PhirePhly/USB-PiDU/README.md

# USB-PiDU
Multiple switchable USB DCP power ports on a Raspberry Pi-sized board
