PhirePhly/USB-PiDU/USBPiDU_pcb/BOM.txt

Right angle USB A ports:
  https://www.digikey.com/products/en?keywords=609-1041-ND
  https://www.digikey.com/products/en?keywords=ED2991-ND

Micro USB Connector
  https://www.digikey.com/products/en?keywords=609-4613-1-ND
  http://portal.fciconnect.com/Comergent//fci/drawing/10118192.pdf

USB Load Switch:
  https://www.digikey.com/products/en?keywords=AP22802AW5-7DICT-ND

5mm header:
  https://www.digikey.com/products/en?keywords=277-1667-ND
