PhirePhly/USB-PiDU/USBPiDU_pcb/USBPiDU.kicad_pcb

## KiCad design USBPiDU_pcb/USBPiDU.kicad_pcb (2017-06-24)

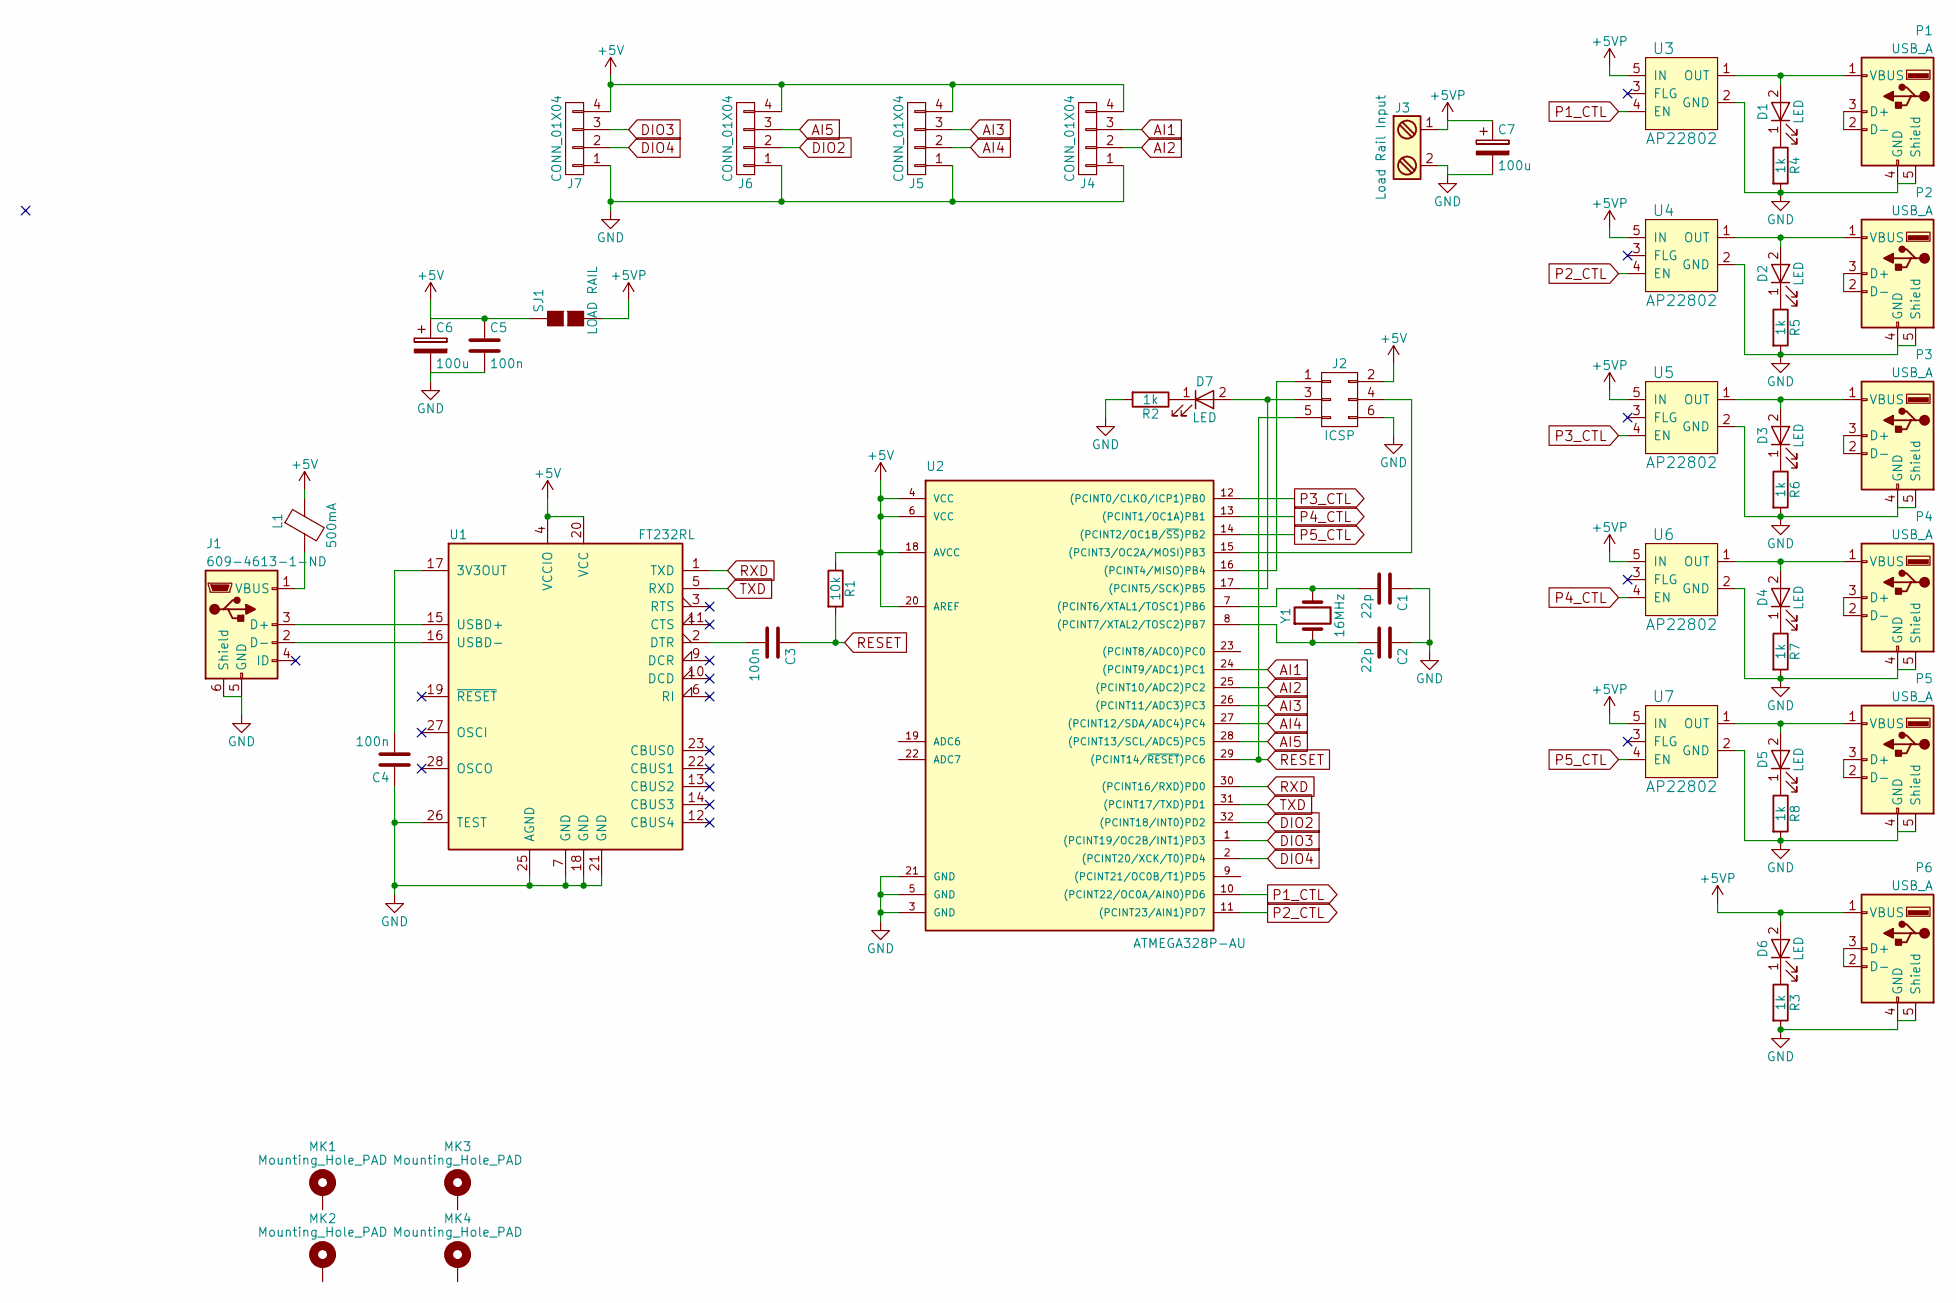
[picture p1: schematic USBPiDU.sch, Arduino USB PDU]

Parts:
C1, C2: 22p; C_0603_HandSoldering
C3, C4, C5: 100n; C_0603_HandSoldering
C6, C7: 100u; CP_Tantalum_Case-X_EIA-7343-43_Hand
D1, D2, D3, D4, D5, D6, D7: LED; LED_0603
J1: 609-4613-1-ND; USB_MicroB_SMT
J2: ICSP; Pin_Header_Straight_2x03_Pitch2.54mm
J3: Load Rail Input; PhoenixContact_MSTBVA-G_02x5.00mm_Vertical
J4, J5, J6, J7: CONN_01X04; Pin_Header_Straight_1x04_Pitch2.54mm
L1: 500mA; L_1206_Handsoldering
MK1, MK2, MK3, MK4: Mounting_Hole_PAD; MountingHole_2.7mm_M2.5_Pad_Via
P1, P2, P3, P4, P5, P6: USB_A; USB_A_RightAngle_side
R1: 10k; R_0603_HandSoldering
R2, R3, R4, R5, R6, R7, R8: 1k; R_0603_HandSoldering
SJ1: LOAD RAIL; GS2
U1: FT232RL; SSOP-28_5.3x10.2mm_Pitch0.65mm
U2: ATMEGA328P-AU; TQFP-32_7x7mm_Pitch0.8mm
U3, U4, U5, U6, U7: AP22802; SOT-25-5
Y1: 16MHz; Crystal_SMD_HC49-SD

Connections:
+5V: C5.1, C6.1, J2.2, J4.4, J5.4, J6.4, J7.4, L1.1, R1.1, SJ1.1 (G1), U1.4 (VCCIO), U1.20 (VCC), U2.4 (VCC), U2.6 (VCC), U2.18 (AVCC), U2.20 (AREF)
+5VP: C7.1, D6.2 (A), J3.1, P6.1 (VBUS), SJ1.2 (G2), U3.5 (IN), U4.5 (IN), U5.5 (IN), U6.5 (IN), U7.5 (IN)
AI1: J4.3, U2.24 ((PCINT9/ADC1)PC1)
AI2: J4.2, U2.25 ((PCINT10/ADC2)PC2)
AI3: J5.3, U2.26 ((PCINT11/ADC3)PC3)
AI4: J5.2, U2.27 ((PCINT12/SDA/ADC4)PC4)
AI5: J6.3, U2.28 ((PCINT13/SCL/ADC5)PC5)
DIO2: J6.2, U2.32 ((PCINT18/INT0)PD2)
DIO3: J7.3, U2.1 ((PCINT19/OC2B/INT1)PD3)
DIO4: J7.2, U2.2 ((PCINT20/XCK/T0)PD4)
GND: C1.1, C2.1, C4.1, C5.2, C6.2, C7.2, J1.5 (GND), J1.6 (Shield), J2.6, J3.2, J4.1, J5.1, J6.1, J7.1, P1.4 (GND), P1.5 (Shield), P2.4 (GND), P2.5 (Shield), P3.4 (GND), P3.5 (Shield), P4.4 (GND), P4.5 (Shield), P5.4 (GND), P5.5 (Shield), P6.4 (GND), P6.5 (Shield), R2.2, R3.2, R4.2, R5.2, R6.2, R7.2, R8.2, U1.7 (GND), U1.18 (GND), U1.21 (GND), U1.25 (AGND), U1.26 (TEST), U2.3 (GND), U2.5 (GND), U2.21 (GND), U3.2 (GND), U4.2 (GND), U5.2 (GND), U6.2 (GND), U7.2 (GND)
unnamed: C1.2, U2.7 ((PCINT6/XTAL1/TOSC1)PB6), Y1.2
unnamed: C2.2, U2.8 ((PCINT7/XTAL2/TOSC2)PB7), Y1.1
unnamed: C3.2, U1.2 (DTR)
unnamed: C4.2, U1.17 (3V3OUT)
unnamed: D1.1 (K), R4.1
unnamed: D1.2 (A), P1.1 (VBUS), U3.1 (OUT)
unnamed: D2.1 (K), R5.1
unnamed: D2.2 (A), P2.1 (VBUS), U4.1 (OUT)
unnamed: D3.1 (K), R6.1
unnamed: D3.2 (A), P3.1 (VBUS), U5.1 (OUT)
unnamed: D4.1 (K), R7.1
unnamed: D4.2 (A), P4.1 (VBUS), U6.1 (OUT)
unnamed: D5.1 (K), R8.1
unnamed: D5.2 (A), P5.1 (VBUS), U7.1 (OUT)
unnamed: D6.1 (K), R3.1
unnamed: D7.1 (K), R2.1
unnamed: D7.2 (A), J2.3, U2.17 ((PCINT5/SCK)PB5)
unnamed: J1.1 (VBUS), L1.2
unnamed: J1.2 (D-), U1.16 (USBD-)
unnamed: J1.3 (D+), U1.15 (USBD+)
unnamed: J2.1, U2.16 ((PCINT4/MISO)PB4)
unnamed: J2.4, U2.15 ((PCINT3/OC2A/MOSI)PB3)
unnamed: P1.2 (D-), P1.3 (D+)
unnamed: P2.2 (D-), P2.3 (D+)
unnamed: P3.2 (D-), P3.3 (D+)
unnamed: P4.2 (D-), P4.3 (D+)
unnamed: P5.2 (D-), P5.3 (D+)
unnamed: P6.2 (D-), P6.3 (D+)
P1_CTL: U2.10 ((PCINT22/OC0A/AIN0)PD6), U3.4 (EN)
P2_CTL: U2.11 ((PCINT23/AIN1)PD7), U4.4 (EN)
P3_CTL: U2.12 ((PCINT0/CLKO/ICP1)PB0), U5.4 (EN)
P4_CTL: U2.13 ((PCINT1/OC1A)PB1), U6.4 (EN)
P5_CTL: U2.14 ((PCINT2/OC1B/~SS~)PB2), U7.4 (EN)
RESET: C3.1, J2.5, R1.2, U2.29 ((PCINT14/~RESET~)PC6)
RXD: U1.1 (TXD), U2.30 ((PCINT16/RXD)PD0)
TXD: U1.5 (RXD), U2.31 ((PCINT17/TXD)PD1)

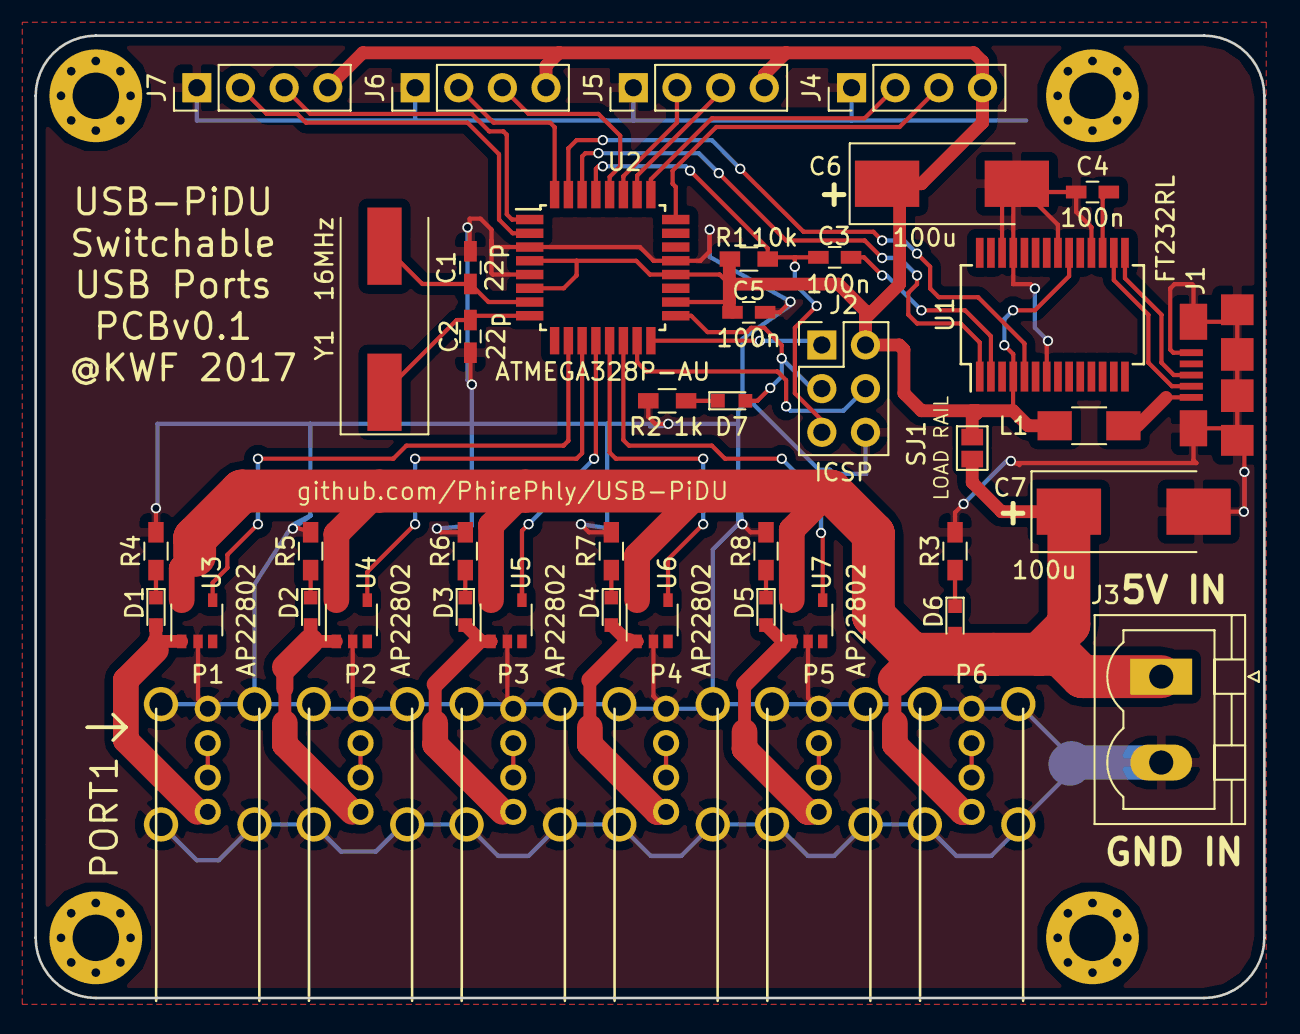
[picture p2: board USBPiDU.kicad_pcb from above]

Board: 2 copper layers, 71.5 x 56.0 mm, 49 parts (0 on the bottom side), 47 nets.
