PhirePhly/USB-PiDU/(threads)

Thread 2 (2017-06-20):

LED footprint loses polarity indication

PhirePhly, 2017-06-20:
The stock KiCAD LED footprint places the polarity silk too close to the footprints. The mask stop removes them and there's no way to identify the polarity on-board.

Closed 2017-06-24.
