PhirePhly/USB-PiDU/(commit log)

2017-06-09 Redid load ports with AP22802 load switch
    [USBPiDU.sch]
2017-06-12 First wag at board layout
    Will probably end up changing port control pinout to improve routing
    and add random IO headers to eat up the rest of the GPIO and board space
    [USBPiDU.kicad_pcb, USBPiDU.sch]
2017-06-20 Final v0.1 board layout
    [USBPiDU.kicad_pcb, USBPiDU.sch]
2017-06-24 Changed pad clearance to 0.075mm (3thou)
    The KiCAD global clearance default of 0.2mm is comically large,
    and wipes out things like LED polarity silk, all mask between pads on
    ICs, etc.
    Closed #2
    [USBPiDU.kicad_pcb]
2017-06-24 Moved vias off 0603 footprints
    No need to place vias on footprints on final routing.
    Closed #1
    [USBPiDU.kicad_pcb]
